mkousal/SmartHotGlue/Dlouhodobá maturitní práce.pptx

## Dlouhodobá maturitní práce Inteligentní tavná pistole

Martin Kousal, S4E
Střední průmyslová škola a Vyšší odborná škola Brno, Sokolská,
příspěvková organizace

## Cíl práce

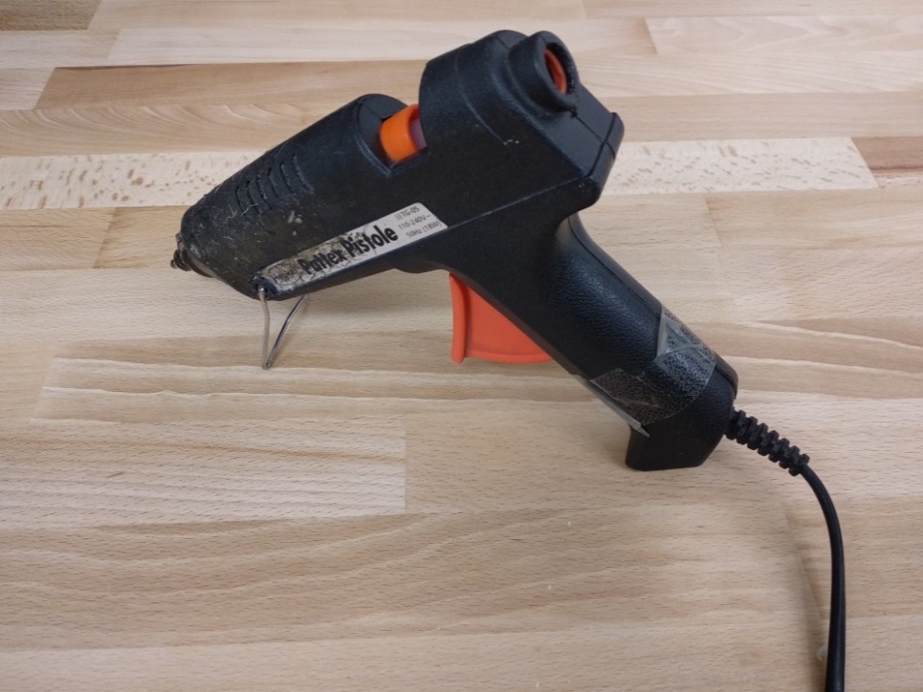
[picture p1: figure]
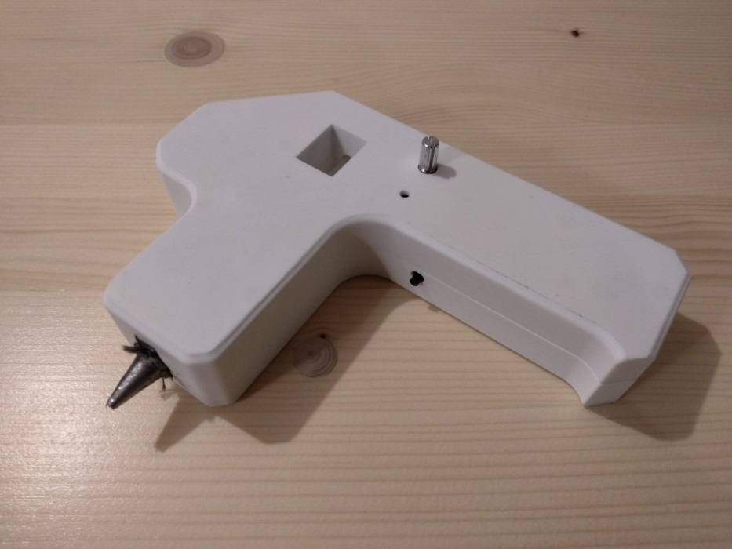
[picture p2: figure]

## Blokové schéma zapojení

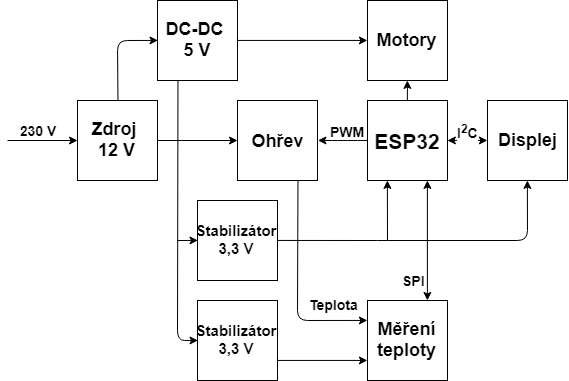
[picture p3: figure]

## Základní komponenty

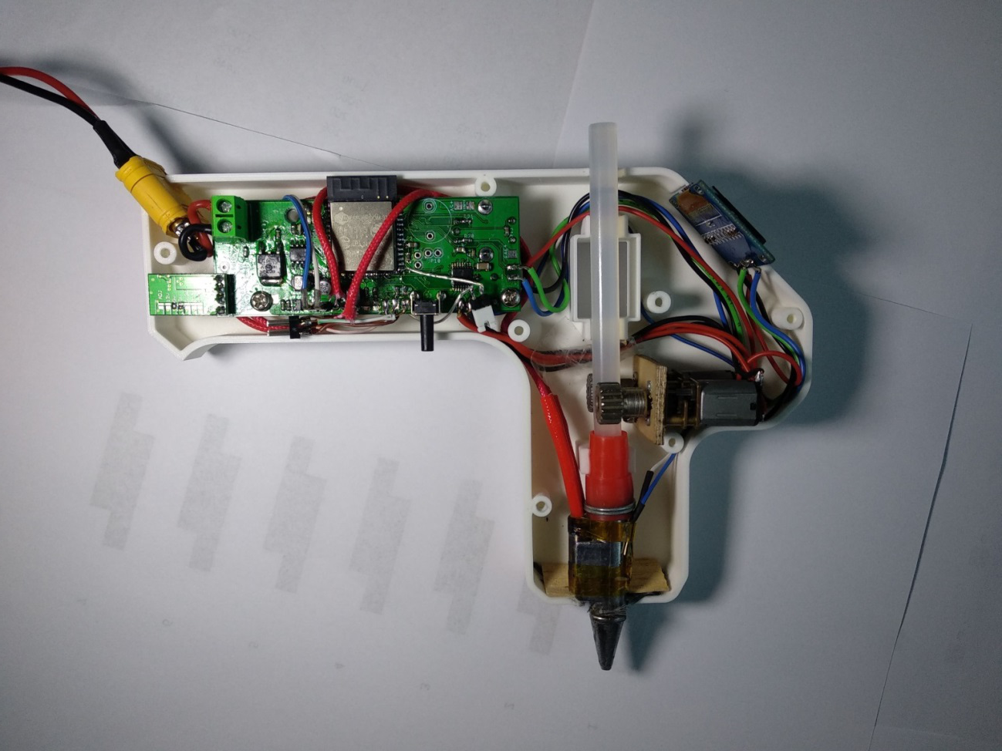
[picture p4: figure]

Řídící elektronika

Displej

Posun lepidla

Motory

Ohřev lepidla

Teplotní čidlo

## Řídící mikrokontrolér – ESP32

Hlavní výhody:
- Wi-Fi + Bluetooth
- Vysoký výkon
- Podpora velkého množství sběrnic
- Nízká cena
- Malé rozměry (25 x 18 mm)

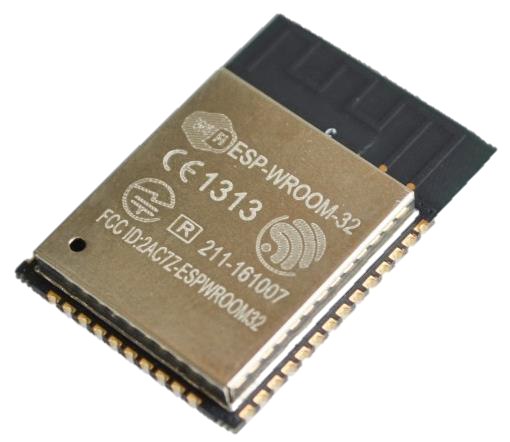
[picture p5: figure]

## Návrh zapojení

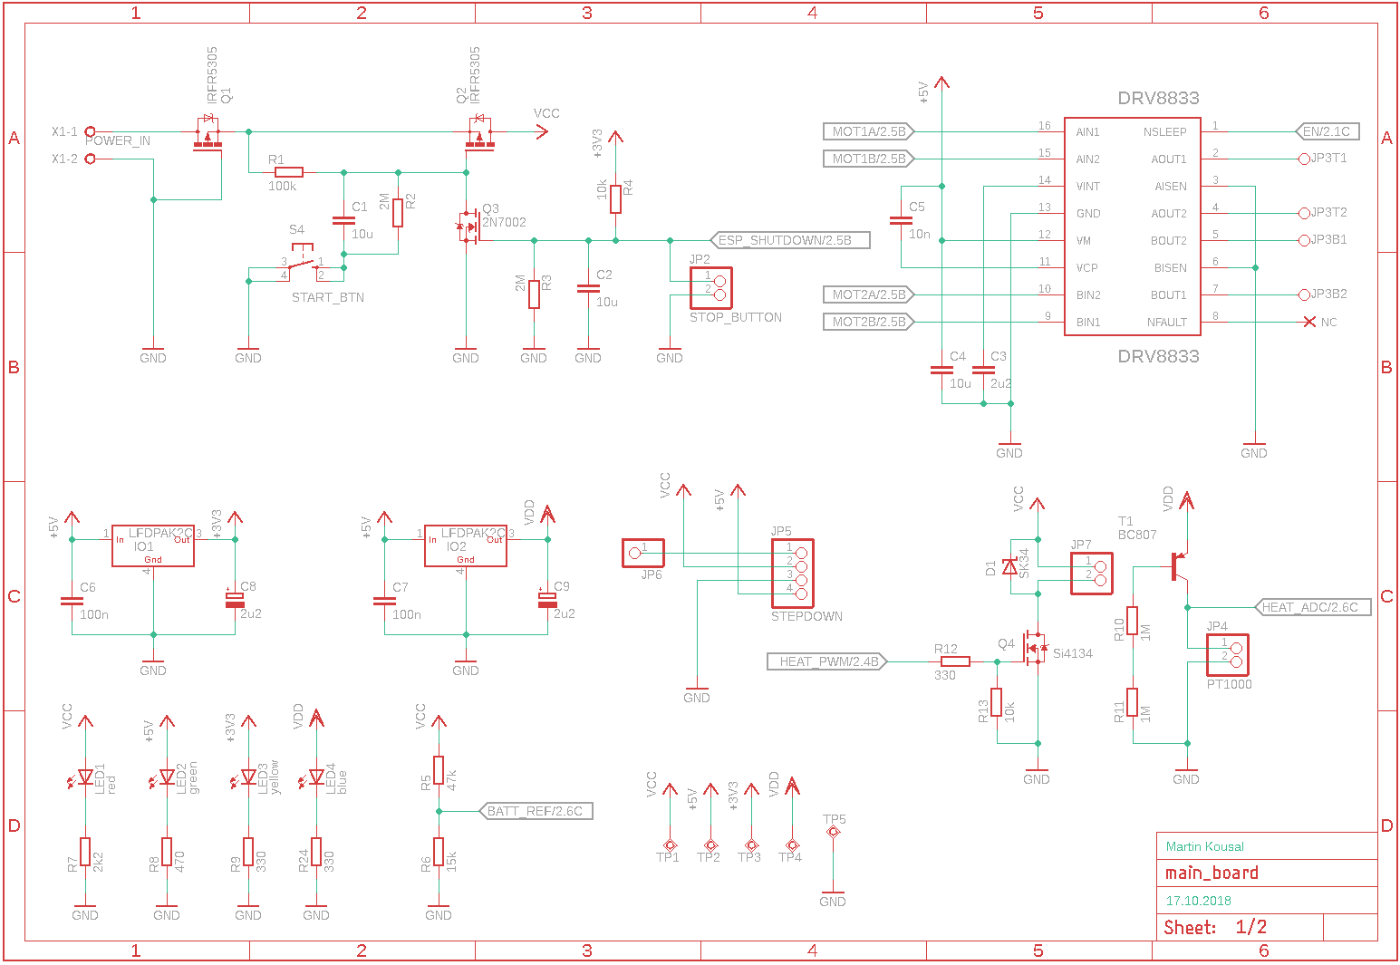
[picture p6: figure]

## Výroba DPS

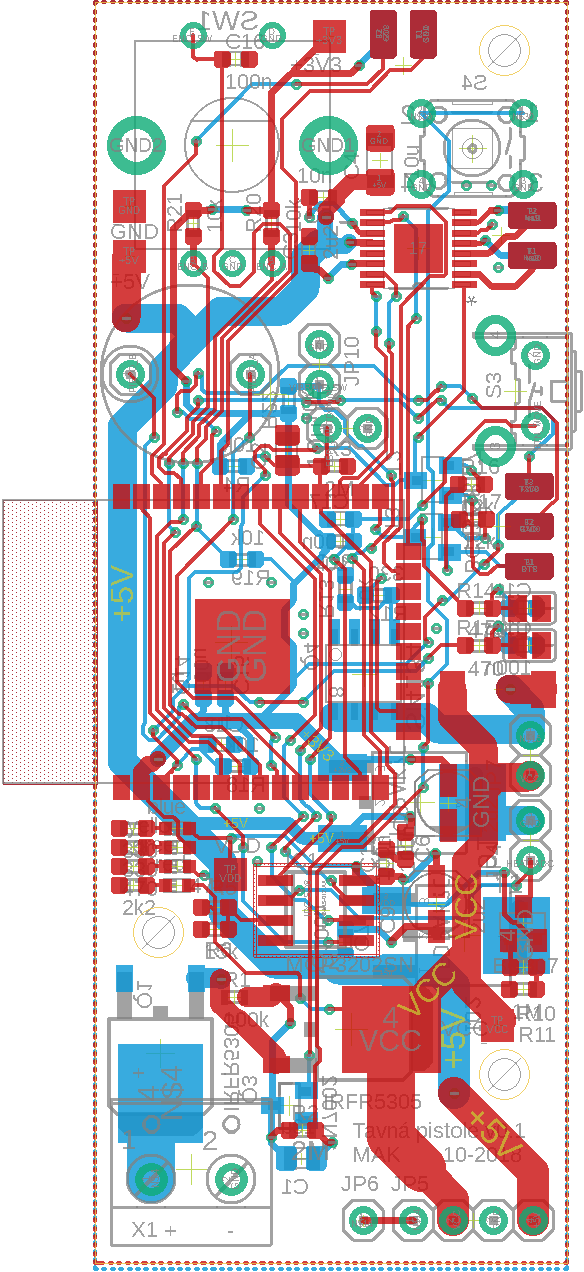
[picture p7: figure]
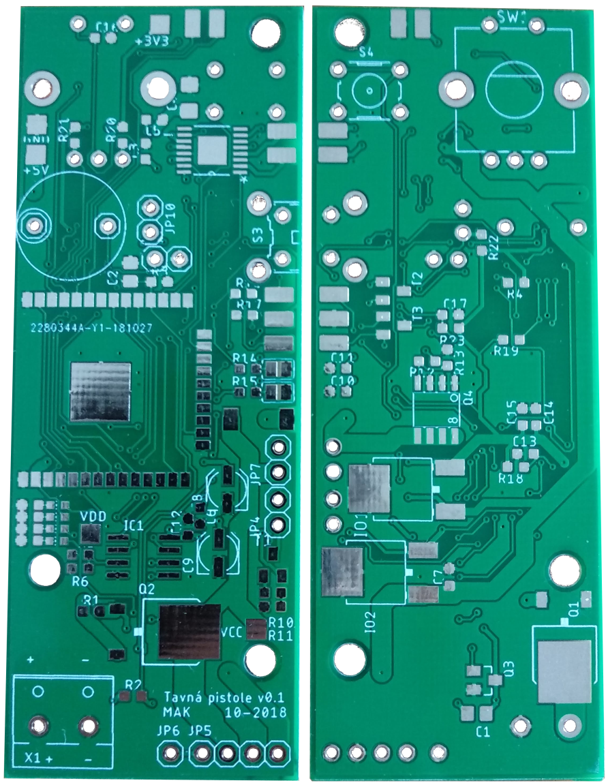
[picture p8: figure]

## Návrh a výroba obalu

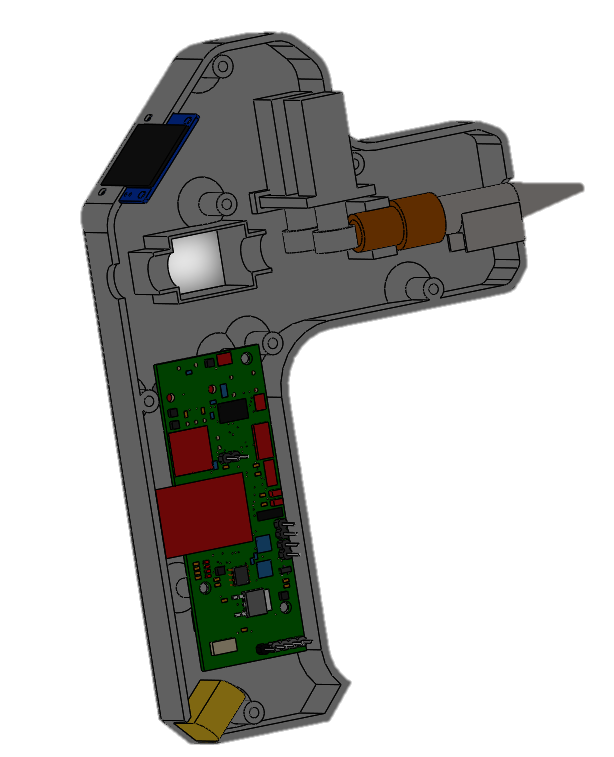
[picture p9: figure]
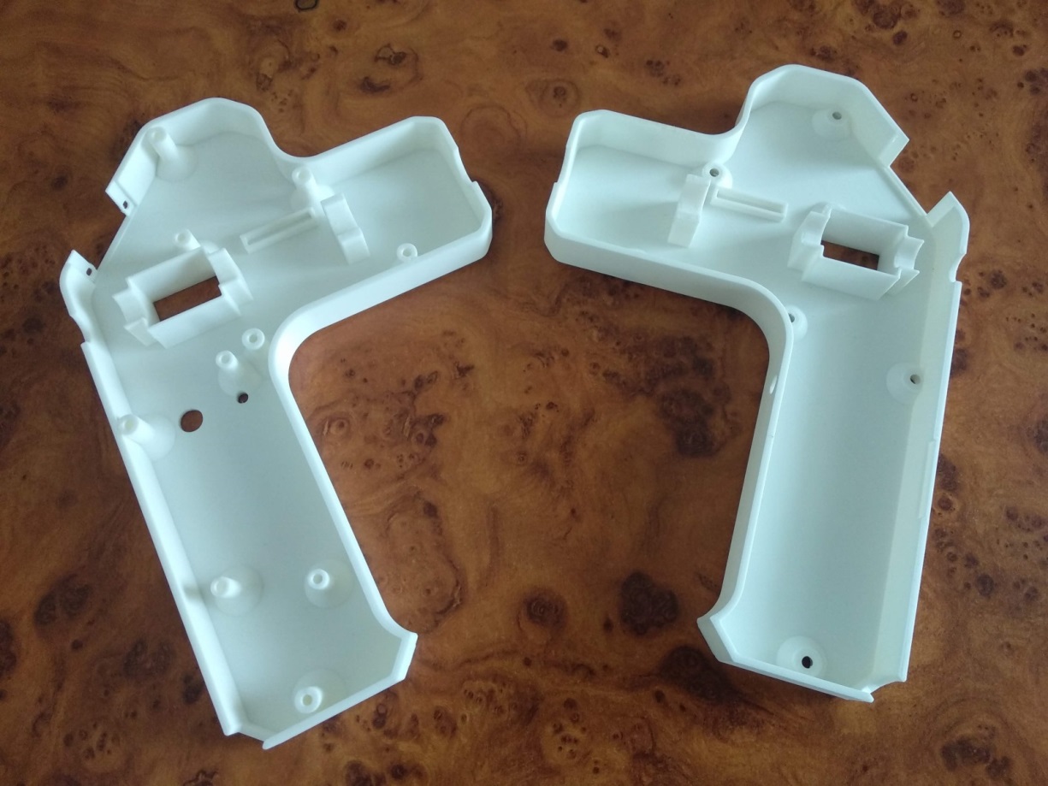
[picture p10: figure]

## Programování

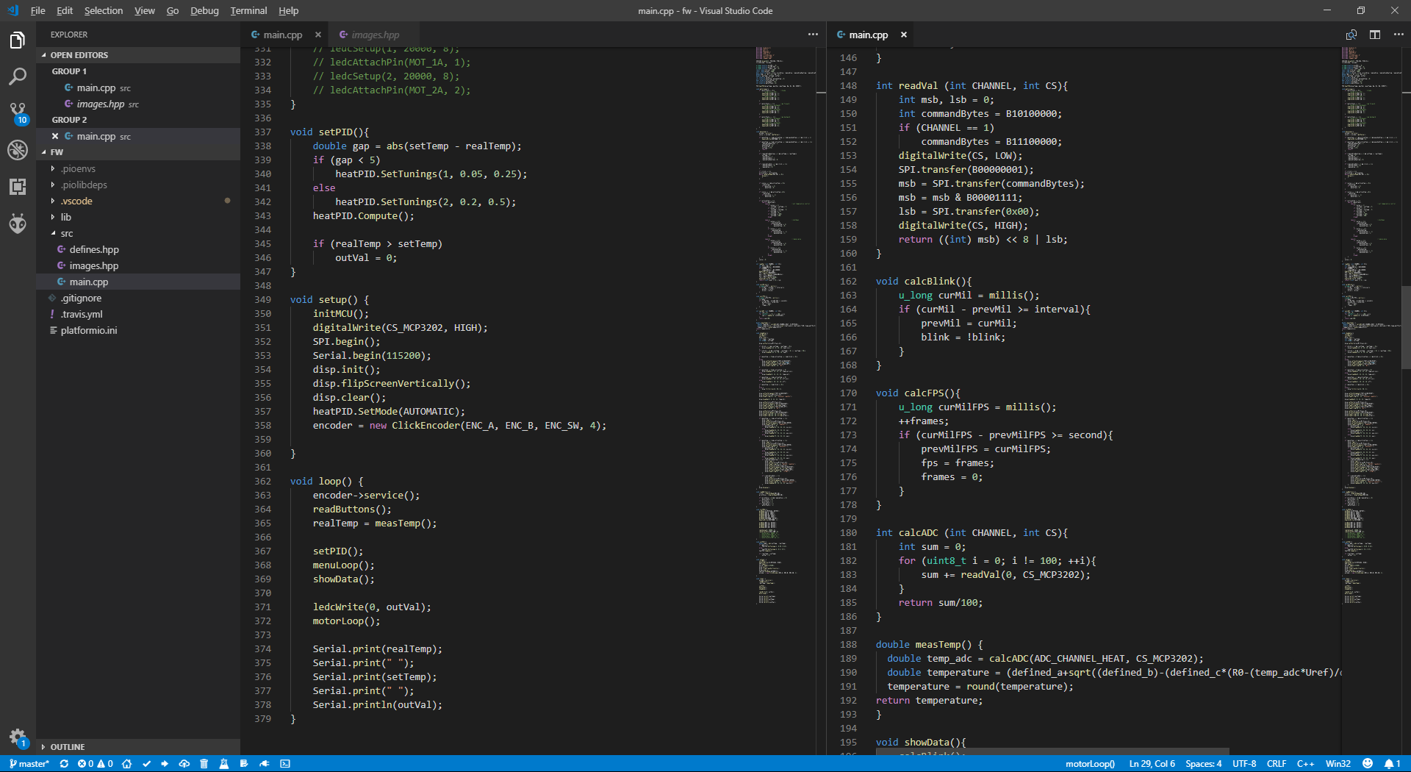
[picture p11: figure]

## Splnění cíle

- Možnost nastavení teploty a její automatické udržování
- Větší uživatelský komfort
- Výrazné zjednodušení práce
- Úspora času a energie

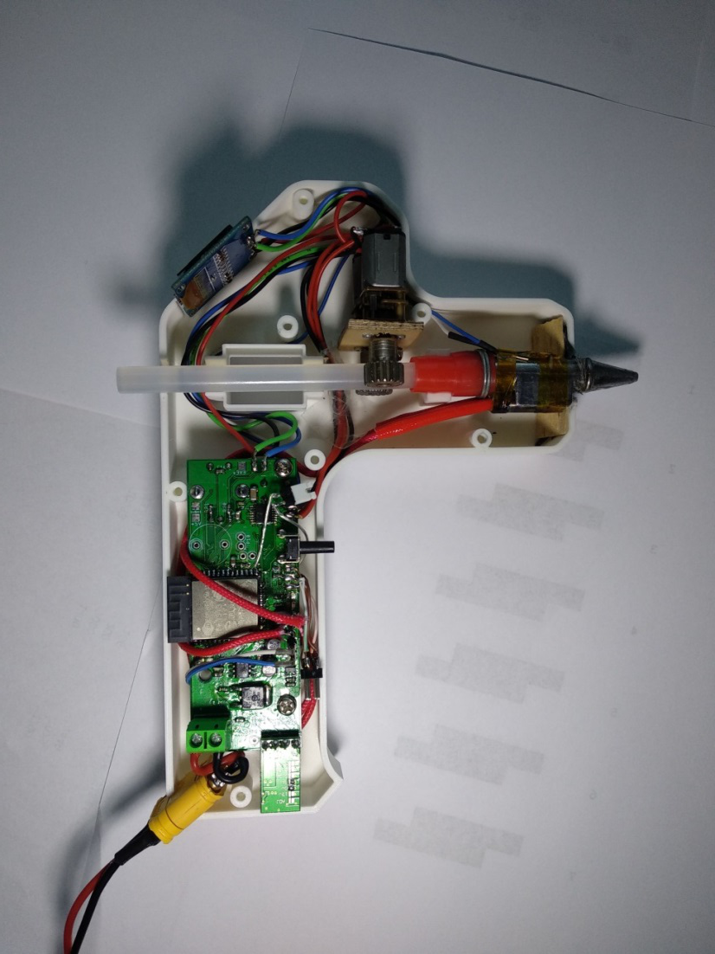
[picture p12: figure]

## Děkuji za pozornost
