mkousal/SmartHotGlue/mec/PISTOLE.SLDASM

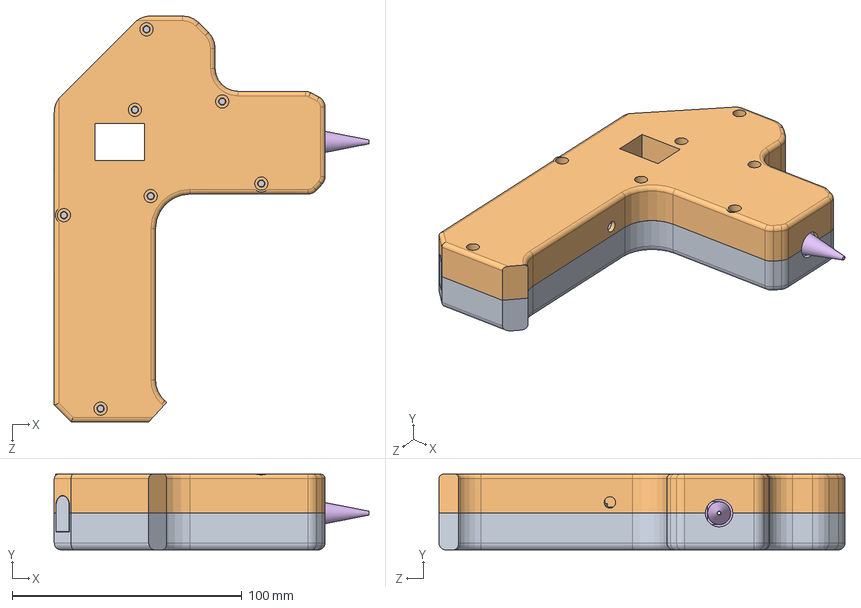
[picture p27: CAD file, 2019-01-22]
mec/PISTOLE.SLDASM
136.9 x 33.0 x 176.7 mm
OBAL_A
Board.step
10u.step x 2
SOP65P640X120-17N.step
PINH2X02SMD.step x 2
blue.step x 4
IRFR5305.step x 2
2N7002.step
330.step x 24
100n.step x 12
10u_1.step
LFDPAK_C.step x 2
2u2.step x 2
BC817.step x 3
MCP3202SN.step
STEPDOWN.step
1X01.step
Si4134.step
SK34.step
ESP-WROOM-32.step
PIEZO.step
PINH2X03SMD.step
VIBRATE_SW.step x 3
POWER_IN.step
EC12E_SW.step
TPSQTP20SQ.step x 5
B3F-31XX.step
START_BTN.step
SJ.step x 2
HOTEND
DISPLAY OLED
MOTORY
XT60
OBAL_B
