mkousal/SmartHotGlue/mec/main_board v16.step

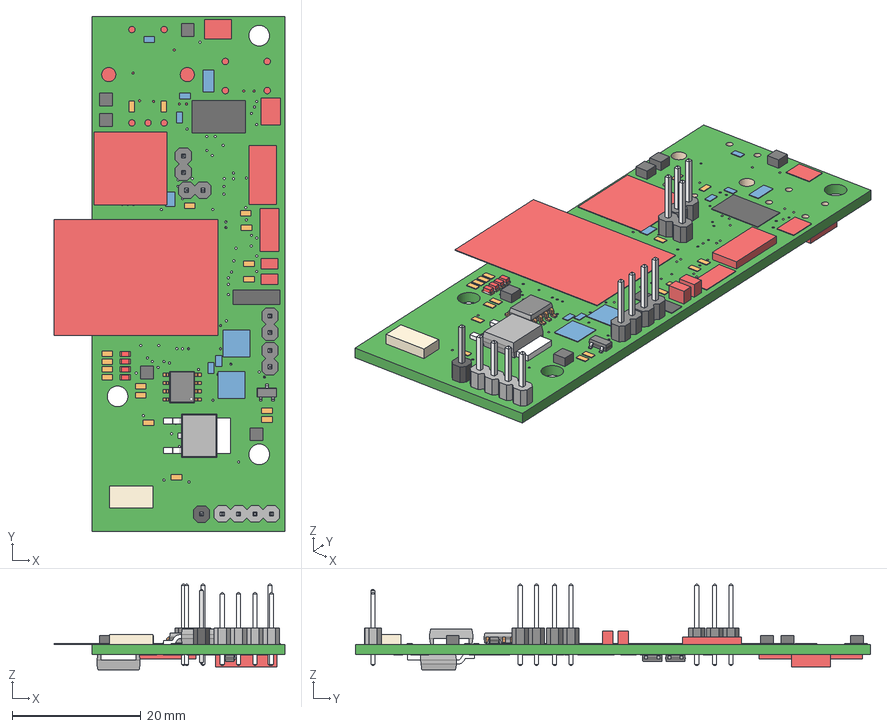
[picture p28: CAD file, 2018-12-31]
mec/main_board v16.step
35.9 x 80.0 x 13.3 mm
Board
10u x 2
SOP65P640X120-17N
PINH2X02SMD x 2
blue x 4
IRFR5305 x 2
2N7002
100n x 12
10u_1
LFDPAK?C x 2
2u2 x 2
BC817 x 3
MCP3202SN
STEPDOWN
1X01
Si4134
SK34
ESP-WROOM-32
PIEZO
PINH2X03SMD
VIBRATE_SW x 4
POWER_IN
EC12E_SW
TPSQTP20SQ x 5
B3F-31XX
START_BTN
SJ x 2
