mkousal/SmartHotGlue/mec/OBAL_B.SLDPRT

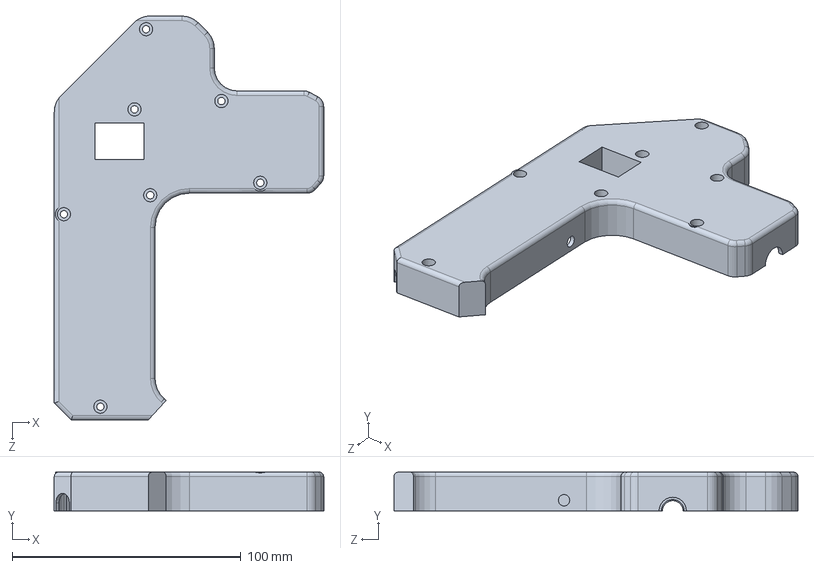
[picture p29: CAD file, 2019-01-22]
mec/OBAL_B.SLDPRT
117.9 x 17.0 x 176.7 mm
