mkousal/SmartHotGlue/mec/OBAL_A.SLDPRT

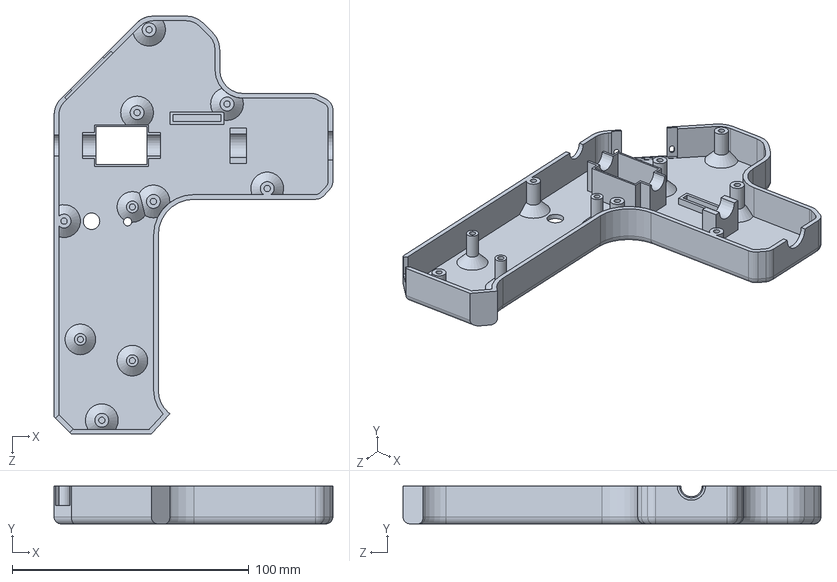
[picture p30: CAD file, 2019-01-22]
mec/OBAL_A.SLDPRT
117.9 x 16.0 x 176.7 mm
