mkousal/SmartHotGlue/mec/DISPLAY OLED.SLDPRT

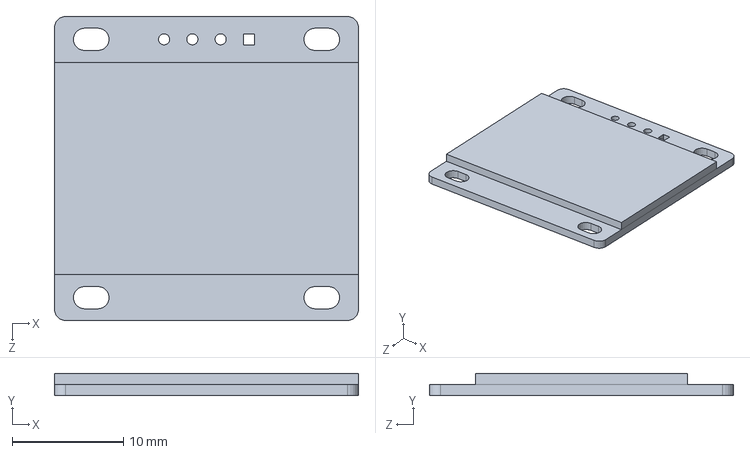
[picture p31: CAD file, 2018-12-31]
mec/DISPLAY OLED.SLDPRT
27.3 x 2.00 x 27.3 mm
