mkousal/SmartHotGlue/mec/XT60.SLDPRT

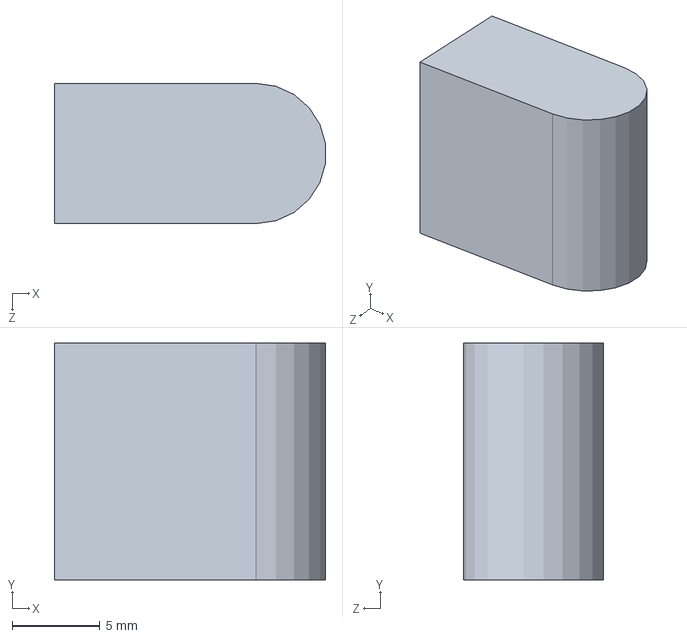
[picture p32: CAD file, 2018-12-31]
mec/XT60.SLDPRT
15.5 x 13.5 x 8.00 mm
