mkousal/SmartHotGlue/mec/HOTEND.SLDPRT

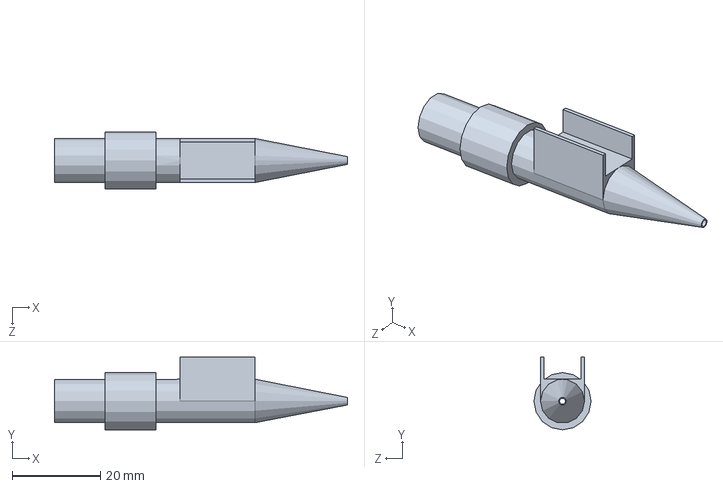
[picture p33: CAD file, 2018-12-31]
mec/HOTEND.SLDPRT
66.5 x 16.5 x 13.0 mm
