mkousal/SmartHotGlue/mec/MOTORY.SLDPRT

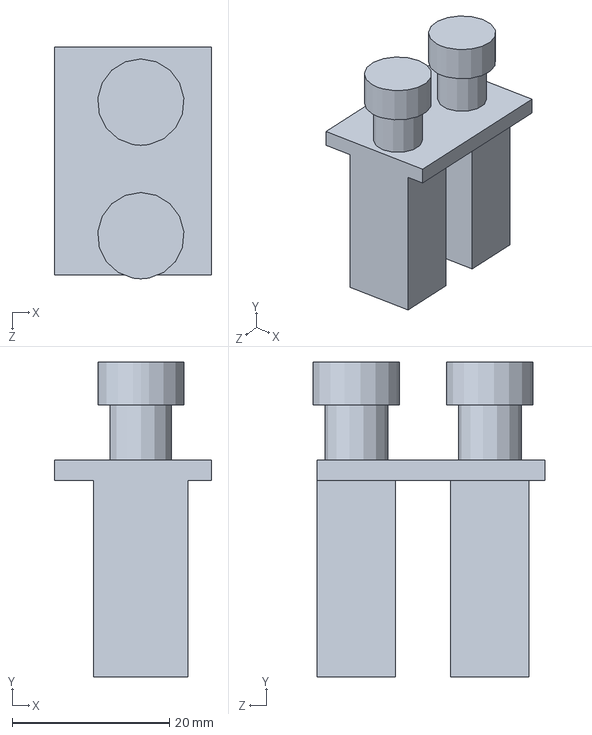
[picture p34: CAD file, 2018-12-31]
mec/MOTORY.SLDPRT
20.0 x 40.1 x 29.5 mm
