mkousal/SmartHotGlue/(list of files, cad)

Other CAD files:
mec/main_board v16.SLDASM
