mkousal/SmartHotGlue/hw/main_board.brd

## EAGLE design hw/main_board.brd (2019-01-28)

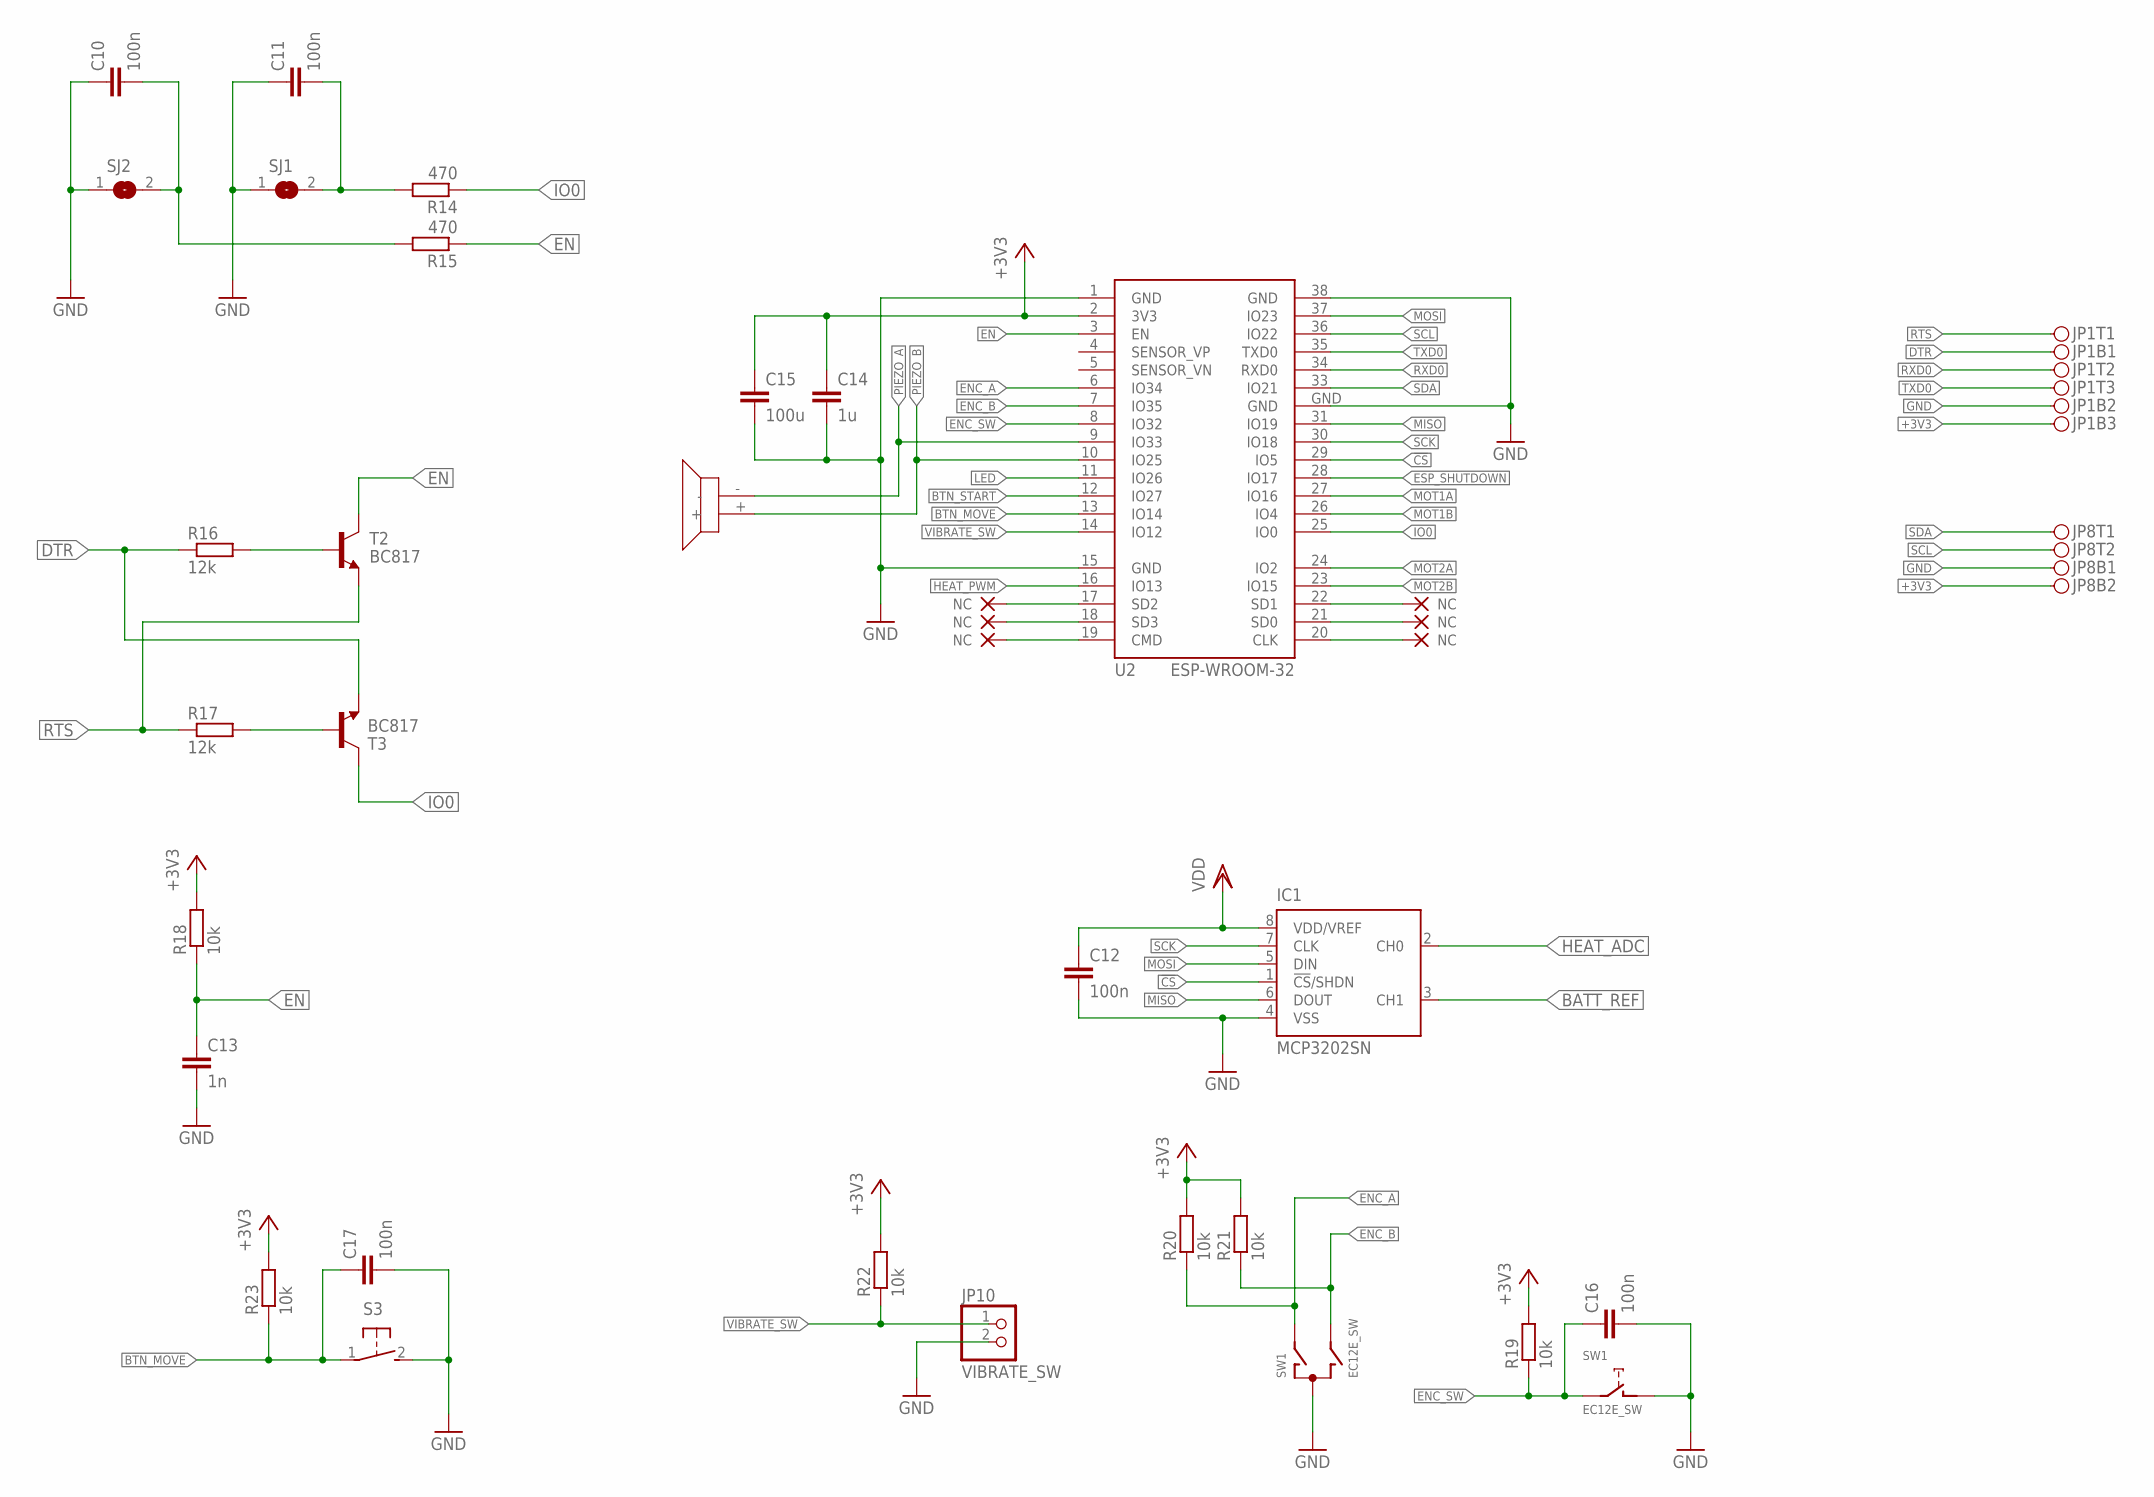
[picture p35: schematic main_board.sch, sheet 1, LOGIC]

Parts:
C10, C11, C12, C16, C17: 100n; C0603
C13: 1n; C0603
C14: 1u; C0603
C15: 100u; C0603
IC1: MCP3202SN; SO-08
JP1: PINH2X03; PINH2X03SMD
JP8: PINH2X02; PINH2X02SMD
JP10: VIBRATE_SW; 1X02
R14, R15: 470; R0603
R16, R17: 12k; R0603
R18, R19, R20, R21, R22, R23: 10k; R0603
S3: 31-XX; B3F-31XX
SJ1, SJ2: SJ
SW1: EC12E_SW; ALPS_EC12E_SW
T2, T3: BC817; SOT23-BEC
U2: ESP-WROOM-32
U$1: PIEZO

Connections:
!CS: IC1.1 (!CS!/SHDN), U2.29 (IO5)
+3V3: C14.1, C15.1, JP1.B3, JP8.B2, R18.2, R19.2, R20.2, R21.2, R22.2, R23.2, U2.2 (3V3); also elsewhere on the board
BATT_REF: IC1.3 (CH1); also elsewhere on the board
BTN_MOVE: C17.1, R23.1, S3.1, U2.13 (IO14)
BTN_START: U2.12 (IO27)
DTR: JP1.B1, R16.1, T3.E
EN: C13.1, R15.1, R18.1, T2.C, U2.3 (EN); also elsewhere on the board
ENC_A: R20.1, SW1.A, U2.6 (IO34)
ENC_B: R21.1, SW1.B, U2.7 (IO35)
ENC_SW: C16.1, R19.1, SW1.E (2), U2.8 (IO32)
ESP_SHUTDOWN: U2.28 (IO17); also elsewhere on the board
GND: C10.1, C11.1, C12.2, C13.2, C14.2, C15.2, C16.2, C17.2, IC1.4 (VSS), JP1.B2, JP8.B1, JP10.2, S3.2 (S), SJ1.1, SJ2.1, SW1.C, SW1.D (1), U2.1 (GND), U2.15 (GND), U2.38 (GND), U2.GND; also elsewhere on the board
HEAT_ADC: IC1.2 (CH0); also elsewhere on the board
HEAT_PWM: U2.16 (IO13); also elsewhere on the board
IO0: R14.1, T3.C, U2.25 (IO0)
LED: U2.11 (IO26)
MISO: IC1.6 (DOUT), U2.31 (IO19)
MOSI: IC1.5 (DIN), U2.37 (IO23)
MOT1A: U2.27 (IO16); also elsewhere on the board
MOT1B: U2.26 (IO4); also elsewhere on the board
MOT2A: U2.24 (IO2); also elsewhere on the board
MOT2B: U2.23 (IO15); also elsewhere on the board
unnamed: R16.2, T2.B
unnamed: C10.2, R15.2, SJ2.2
unnamed: R17.2, T3.B
unnamed: C11.2, R14.2, SJ1.2
PIEZO_A: U2.9 (IO33), U$1.-
PIEZO_B: U2.10 (IO25), U$1.+
RTS: JP1.T1, R17.1, T2.E
RXD0: JP1.T2, U2.34 (RXD0)
SCK: IC1.7 (CLK), U2.30 (IO18)
SCL: JP8.T2, U2.36 (IO22)
SDA: JP8.T1, U2.33 (IO21)
TXD0: JP1.T3, U2.35 (TXD0)
VDD: C12.1, IC1.8 (VDD/VREF); also elsewhere on the board
VIBRATE_SW: JP10.1, R22.1, U2.14 (IO12)

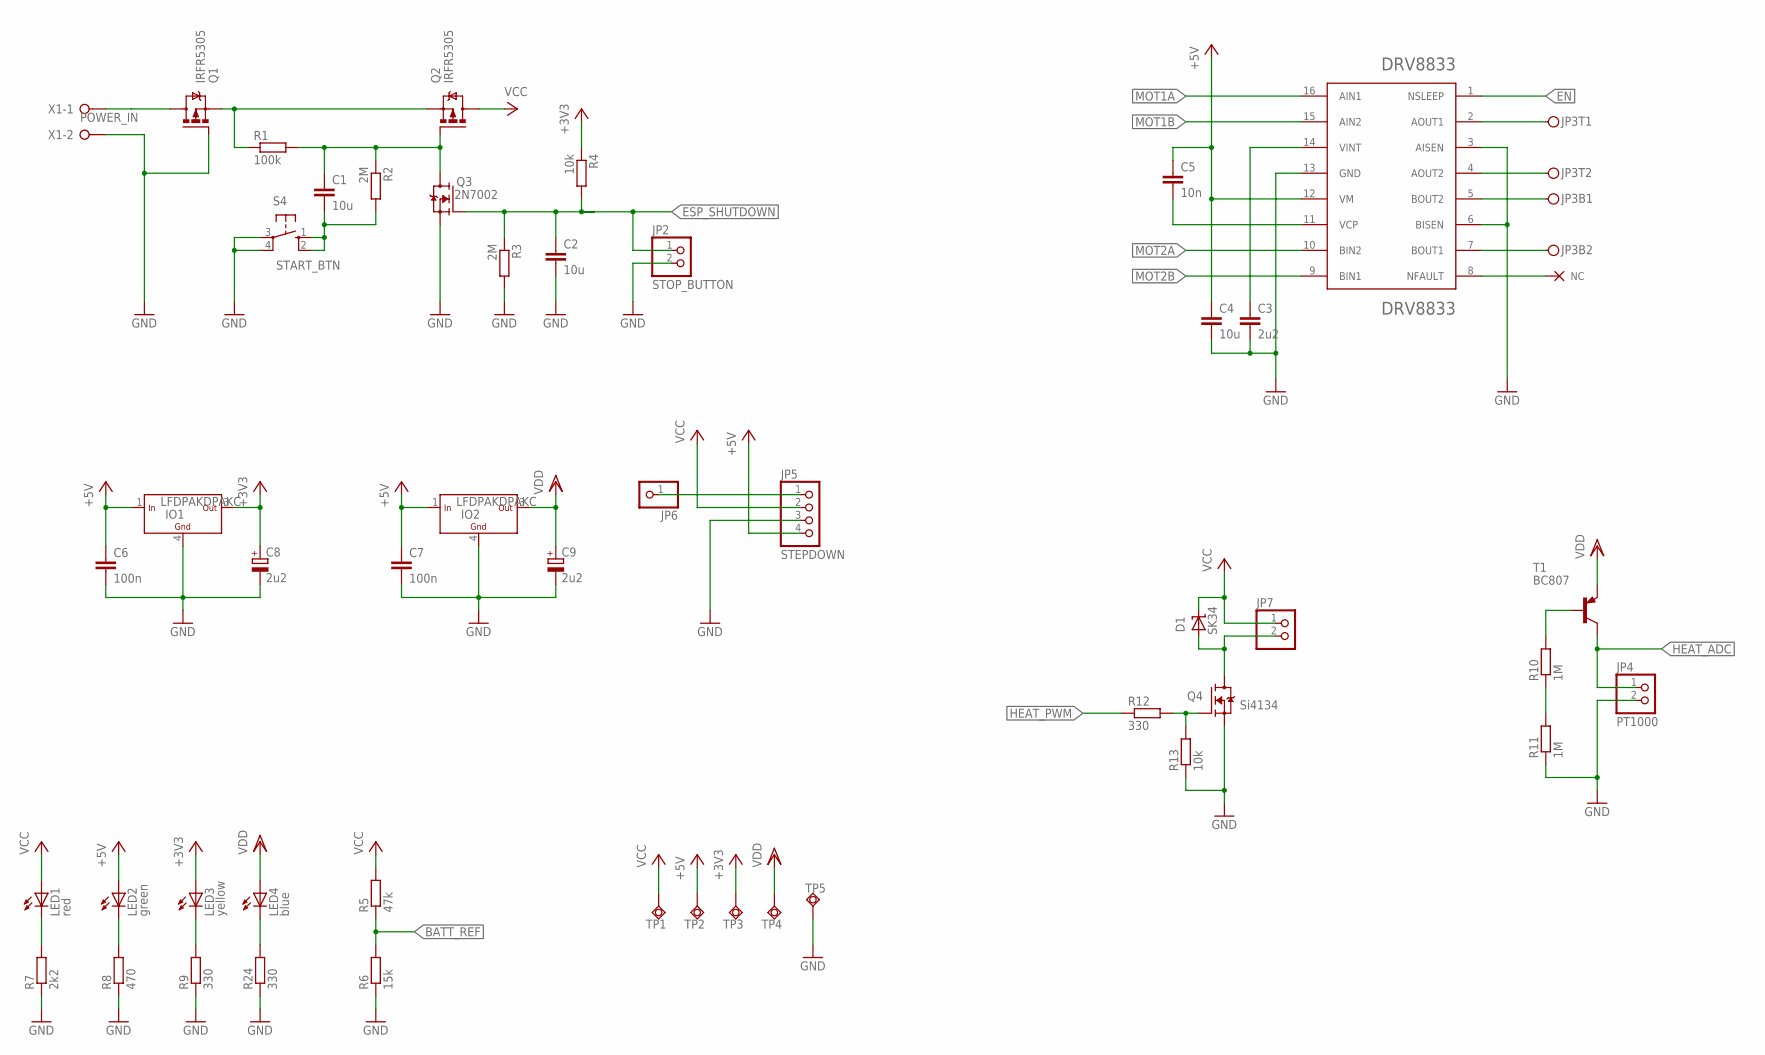
[picture p36: schematic main_board.sch, sheet 2, POWER]

Parts:
C1, C2: 10u; C0805
C3: 2u2; C0603
C4: 10u; C1206
C5: 10n; C0603
C6, C7: 100n; C0603
C8, C9: 2u2; UD-4X5,8_NICHICON
D1: SK34; SMB
DRV8833PWP1: DRV8833; SOP65P640X120-17N
IO1, IO2: LFDPAKDPAKC; DPAK
JP2: STOP_BUTTON; 1X02
JP3: PINH2X02; PINH2X02SMD
JP4: PT1000; 1X02
JP5: STEPDOWN; 1X04
JP6: PINHD-1X1; 1X01
JP7: PINHD-1X2; 1X02
LED1: red; CHIP-LED0603
LED2: green; CHIP-LED0603
LED3: yellow; CHIP-LED0603
LED4: blue; CHIP-LED0603
Q1, Q2: IRFR5305; D-PAK_TO252AA
Q3: 2N7002; SOT23
Q4: Si4134; SO-8
R1: 100k; R0603
R2, R3: 2M; R0603
R4, R13: 10k; R0603
R5: 47k; R0603
R6: 15k; R0603
R7: 2k2; R0603
R8: 470; R0603
R9, R12, R24: 330; R0603
R10, R11: 1M; R0603
S4: START_BTN; B3F-10XX
T1: BC807; SOT23-BEC
TP1, TP2, TP3, TP4, TP5: TPSQTP20SQ; TP20SQ
X1: POWER_IN; W237-132

Connections:
+3V3: C8.+, IO1.3 (OUT), LED3.A, R4.1, TP3.TP; also elsewhere on the board
+5V: C4.1, C5.1, C6.1, C7.1, DRV8833PWP1.12 (VM), IO1.1 (IN), IO2.1 (IN), JP5.4, LED2.A, TP2.TP
BATT_REF: R5.1, R6.2; also elsewhere on the board
EN: DRV8833PWP1.1 (NSLEEP); also elsewhere on the board
ESP_SHUTDOWN: C2.1, JP2.1, Q3.1 (G), R3.1, R4.2; also elsewhere on the board
GND: C2.2, C3.2, C4.2, C6.2, C7.2, C8.-, C9.-, DRV8833PWP1.3 (AISEN), DRV8833PWP1.6 (BISEN), DRV8833PWP1.13 (GND), IO1.4 (GND), IO2.4 (GND), JP2.2, JP4.2, JP5.3, Q1.1 (G), Q3.2 (S), Q4.1 (S), Q4.2 (S), Q4.3 (S), R3.2, R6.1, R7.1, R8.1, R9.1, R11.1, R13.1, R24.1, S4.3, S4.4 (P1), TP5.TP, X1.2; also elsewhere on the board
HEAT_ADC: JP4.1, T1.C; also elsewhere on the board
HEAT_PWM: R12.1; also elsewhere on the board
MOT1A: DRV8833PWP1.16 (AIN1); also elsewhere on the board
MOT1B: DRV8833PWP1.15 (AIN2); also elsewhere on the board
MOT2A: DRV8833PWP1.10 (BIN2); also elsewhere on the board
MOT2B: DRV8833PWP1.9 (BIN1); also elsewhere on the board
unnamed: Q1.3 (S), Q2.3 (S), R1.1
unnamed: C1.1, Q2.1 (G), Q3.3 (D), R1.2, R2.1
unnamed: LED4.C, R24.2
unnamed: Q1.4 (D), X1.1
unnamed: LED3.C, R9.2
unnamed: LED2.C, R8.2
unnamed: LED1.C, R7.2
unnamed: DRV8833PWP1.2 (AOUT1), JP3.T1
unnamed: DRV8833PWP1.4 (AOUT2), JP3.T2
unnamed: DRV8833PWP1.5 (BOUT2), JP3.B1
unnamed: DRV8833PWP1.7 (BOUT1), JP3.B2
unnamed: C3.1, DRV8833PWP1.14 (VINT)
unnamed: JP5.1, JP6.1
unnamed: C5.2, DRV8833PWP1.11 (VCP)
unnamed: D1.A, JP7.2, Q4.5 (D), Q4.6 (D), Q4.7 (D), Q4.8 (D)
unnamed: R10.1, R11.2
unnamed: R10.2, T1.B
unnamed: Q4.4 (G), R12.2, R13.2
unnamed: C1.2, R2.2, S4.1 (S), S4.2 (S1)
VCC: D1.C, JP5.2, JP7.1, LED1.A, Q2.4 (D), R5.2, TP1.TP
VDD: C9.+, IO2.3 (OUT), LED4.A, T1.E, TP4.TP; also elsewhere on the board

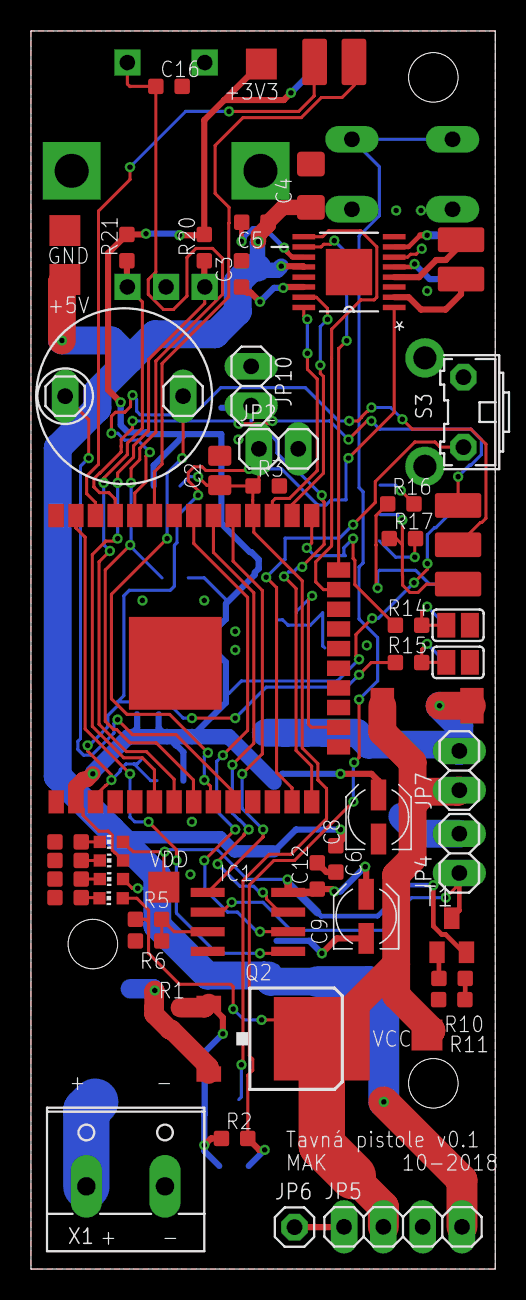
[picture p37: board main_board.brd from above]

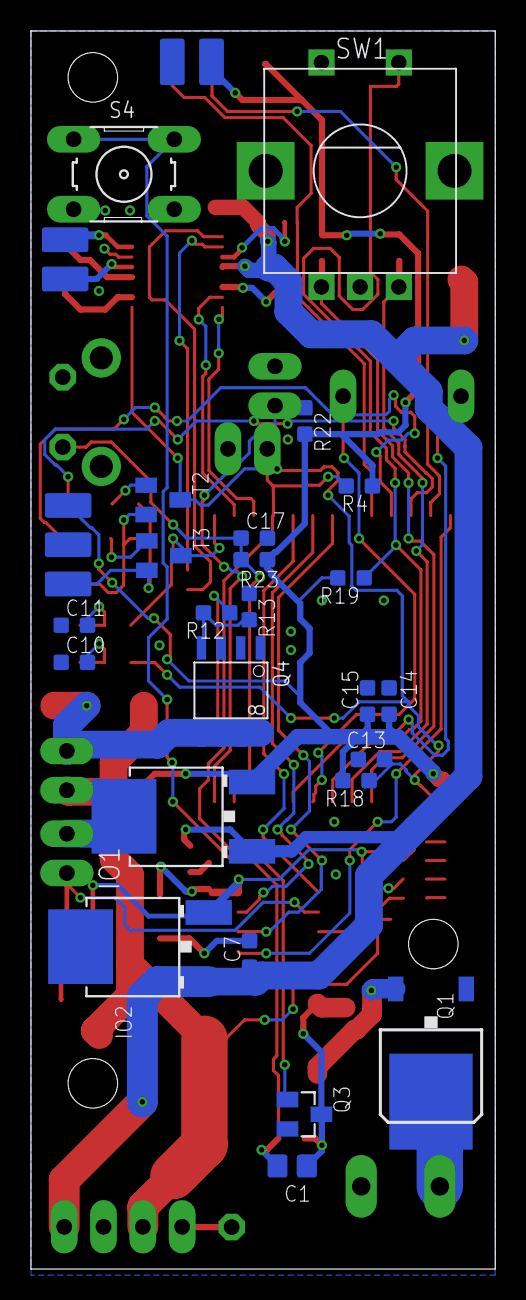
[picture p38: board main_board.brd from below]

Board: 2 copper layers, 30.0 x 80.0 mm, 79 parts (24 on the bottom side), 55 nets.
