mkousal/SmartHotGlue/fw/src/images.hpp

const char heat[32] PROGMEM = {
0x00, 0x00, 0x00, 0x00, 0x88, 0x08, 0x10, 0x11, 0x10, 0x11, 0x10, 0x11, 0x88, 0x08, 0x44, 0x04, 
0x44, 0x04, 0x44, 0x04, 0x88, 0x08, 0x10, 0x11, 0x00, 0x00, 0x00, 0x00, 0xFE, 0x7F, 0x00, 0x00
};
const char heat_inv[32] PROGMEM = {
0xFF, 0xFF, 0xFF, 0xFF, 0x77, 0xF7, 0xEF, 0xEE, 0xEF, 0xEE, 0xEF, 0xEE, 0x77, 0xF7, 0xBB, 0xFB, 
0xBB, 0xFB, 0xBB, 0xFB, 0x77, 0xF7, 0xEF, 0xEE, 0xFF, 0xFF, 0xFF, 0xFF, 0x01, 0x80, 0xFF, 0xFF
};
const char temp[128] PROGMEM = {
0x00, 0x00, 0x00, 0x00, 0x00, 0xC0, 0x03, 0x00, 0x00, 0x20, 0x04, 0x00, 0x00, 0x10, 0x08, 0x00, 
0x00, 0x10, 0x08, 0x00, 0x00, 0x10, 0x0E, 0x00, 0x00, 0x10, 0x08, 0x00, 0x00, 0x10, 0x0E, 0x00, 
0x00, 0x10, 0x08, 0x00, 0x00, 0x10, 0x0E, 0x00, 0x00, 0x10, 0x08, 0x00, 0x00, 0x10, 0x0E, 0x00, 
0x00, 0x10, 0x08, 0x00, 0x00, 0x10, 0x0E, 0x00, 0x00, 0x10, 0x08, 0x00, 0x00, 0x10, 0x0E, 0x00, 
0x00, 0x10, 0x08, 0x00, 0x00, 0x10, 0x0E, 0x00, 0x00, 0x10, 0x08, 0x00, 0x00, 0x10, 0x08, 0x00, 
0x00, 0x08, 0x10, 0x00, 0x00, 0x04, 0x20, 0x00, 0x00, 0x02, 0x40, 0x00, 0x00, 0x02, 0x40, 0x00, 
0x00, 0x02, 0x40, 0x00, 0x00, 0x02, 0x40, 0x00, 0x00, 0x02, 0x40, 0x00, 0x00, 0x02, 0x40, 0x00, 
0x00, 0x04, 0x20, 0x00, 0x00, 0x08, 0x10, 0x00, 0x00, 0xF0, 0x0F, 0x00, 0x00, 0x00, 0x00, 0x00
};
const char temp_24[72] PROGMEM = {
0x00, 0x00, 0x00, 0x00, 0x18, 0x00, 0x00, 0x24, 0x00, 0x00, 0x42, 0x00, 0x00, 0x72, 0x00, 0x00, 
0x42, 0x00, 0x00, 0x72, 0x00, 0x00, 0x42, 0x00, 0x00, 0x72, 0x00, 0x00, 0x42, 0x00, 0x00, 0x72, 
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
0x7E, 0xF8, 0x81, 0x7F, 0x7E, 0x70, 0xC0, 0x7F, 0x7E, 0x20, 0xE0, 0x7F, 0xFE, 0x00, 0xF0, 0x7F, 
0xFE, 0x01, 0xFC, 0x7F, 0xFE, 0x03, 0xFE, 0x7F, 0xFE, 0x07, 0xFF, 0x7F, 0xFE, 0x8F, 0xFF, 0x7F, 
0xFE, 0xFF, 0xFF, 0x7F, 0xFE, 0xFF, 0xFF, 0x7F, 0xFD, 0xFF, 0xFF, 0xBF, 0x03, 0x00, 0x00, 0xC0
};
