mkousal/SmartHotGlue/(commit log)

2018-12-13 Maybe finish work
    Updated and added menu things
    Motors now work
    Added removing of glue
2018-12-31 Add model of packaging
    [DISPLAY OLED.SLDPRT, HOTEND.SLDPRT, MOTORY.SLDPRT, OBAL_A.SLDPRT, OBAL_B.SLDPRT, PISTOLE.SLDASM, XT60.SLDPRT, main_board v16.SLDASM]
2019-01-22 Tune PID, make larger package
    [OBAL_A.SLDPRT, OBAL_B.SLDPRT, PISTOLE.SLDASM]
2019-01-28 Add UART and I2C chapter to thesis
2019-01-28 Add SPI chapter to thesis
2019-01-28 Add all EAGLE project files
    [main_board.brd, main_board.sch]
2019-02-12 Shrinked schematic to A4 paper
    [main_board.sch]
