mkousal/SmartHotGlue/(notices)

Notices in the files:
parts and their libraries:
esp32: Creative Commons Attribution-ShareAlike 4.0 International
Copyright (C) PaJa 2001-2011
